FUTURETECH6/GateGuard/README.md

# GateGuard
 A DIY Visitor Identification System based on Arduino
