FUTURETECH6/GateGuard/Other/3.png

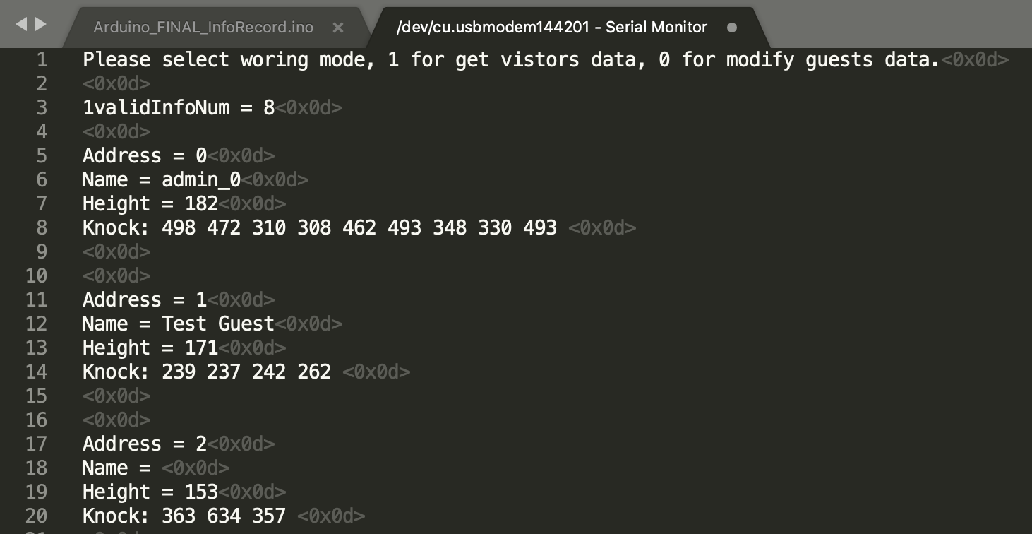
Other/3.png
